cosicmarko1/automatic_dog_feeder/README.md

Embedded C/C++ project for automatic dog feeder using esp32 microcontroller
