cosicmarko1/automatic_dog_feeder/code/waterPump/waterPump.ino

#include "HX711.h"
// DOUT, SCK
HX711 scale(23, 19); 

// calibration factor for 1kg scale is -915
float calibration_factor = -915;
float units;
float ounces;

void setup() {
  Serial.begin(9600);
  pinMode(26, OUTPUT);
  Serial.println("HX711 weighing");
  scale.set_scale(calibration_factor);
  scale.tare();  // Reset the scale to 0
  Serial.println("Readings: ");
}

void loop() {
  Serial.print("Reading: ");
  units = scale.get_units(), 10;
  if (units < 0) {
    units = 0.00;
  }

  if(units < 50) {
    digitalWrite(26, HIGH); 
    delay(1000);             
    digitalWrite(26, LOW);  
    delay(1000);            
  }

  ounces = units * 0.035274;
  Serial.print(units);
  Serial.println(" grams");
  delay(1000);
}
