cosicmarko1/automatic_dog_feeder/code/loadCellCalibrate/loadCellCalibrate.ino

#include "HX711.h"

HX711 scale(25, 26);

// calibration factor for 1kg scale is -1170
float calibration_factor = -900;
float units;
float ounces;

void setup() {
  Serial.begin(9600);
  Serial.println("HX711 calibration sketch");
  Serial.println("Remove all weight from scale");
  Serial.println("After readings begin, place known weight on scale");
  Serial.println("Press + or a to increase calibration factor");
  Serial.println("Press - or z to decrease calibration factor");

  scale.set_scale();
  scale.tare();  // Reset the scale to 0

  long zero_factor = scale.read_average();  // Get a baseline reading
  Serial.print("Zero factor: ");  // This can be used to remove the need to tare the scale. Useful in permanent scale projects.
  Serial.println(zero_factor);
}

void loop() {
  scale.set_scale(calibration_factor);  // Adjust to this calibration factor

  Serial.print("Reading: ");
  units = scale.get_units(), 10;
  if (units < 0) {
    units = 0.00;
  }
  ounces = units * 0.035274;
  Serial.print(units);
  Serial.print(" grams"); 
  Serial.print(" calibration_factor: ");
  Serial.print(calibration_factor);
  Serial.println();

  if(Serial.available()) {
    char temp = Serial.read();
    if(temp == '+' || temp == 'a')
      calibration_factor += 1;
    else if(temp == '-' || temp == 'z')
      calibration_factor -= 1;
  }
}
