cosicmarko1/automatic_dog_feeder/(commit log)

2023-11-08 Implemented basic controlling for the stepper motor
2023-12-29 Implemented load cell calibration and basic controlling for the scale
2024-02-06 Updated load factor for 1kg load cell
2024-02-06 Implemented choosing time and dog size with buttons on LCD display
2024-02-08 Implemented water pump controlling depending on the load cell value
